microfarad-de/smart-pump/README.md

# Smart Water Pump

<p align="center">
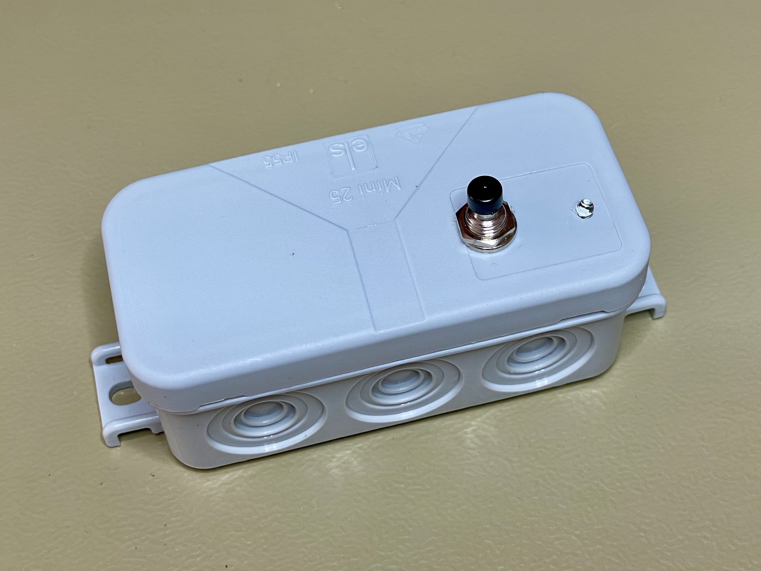
[picture p1: doc/enclosure-1.jpeg]
  
</p>

This repository contains the Arduino firmware for smart water pump controller.

The code has been implemented and tested on an Arduino Pro Mini clone board based on the ATmega328P microcontroller.

This project uses Git submodules. In order to get its full source code, please clone this Git repository to your local workspace, then execute the follwoing command from within the repository's root directory: `git submodule update --init`.

Unless stated otherwise within the source file headers, please feel free to use and distribute this code under the GNU General Public License v3.0.

## Prerequisites

* ATmega328P based Arduino Pro Mini, Arduino Nano or similar model
* Desolder the on board voltage regulator and power LED from the Arduino board
* Custom bootloader from: https://github.com/microfarad-de/bootloader

## Theory of Operation

The smart water pump controller is a convenience feature for caravaning applications.
The caravan's on board water tank is filled using a portable canister.
A 12 Volt water pump is often used to transfer the water from the canister into the on board tank.

The smart pump controller has the following features:
* Automatically deactivate the water pump if it runs dry
* Automatically deactivate the water pump if the caravan tank becomes full
* Top up the caravan tank when the caravan tank water level goes below the full threashold

The controller detects pump dry run condition by measuring its current draw.
The following table shows the approximate current draw of a "Comet Lux-Plus" water pump at 13.0 V:

| State | Current  |
|---|---|
| Pumping | 3.7 A |
| Output blocked | 2.4 A |
| Dry run | 0.6 A |

The controller sends AC voltage pulses across a pair of electrodes plunged into the caravan tank, and measures the resulting voltage drop in order to detect the full tank condition.

Pumping is started and stopped by pressing the push button. The pump will be automatically deactivated if the dry run condition has been detected.

If the full tank condition is detected, the controller will deactivate the pump and go into the standby mode. Whereas the controller will reactivate the water pump if
the water level inside the caravan tank goes below the preset full threshold.

A status LED indicates the operation status through different blinking patterns as shown in the table below:

| Blinking Pattern | Description |
|---|---|
| Always on | Pumping water |
| Always off | Power off state, press button to start pumping |
| Blink once every 2 s | Standby state, the pump will start periodically  |
| Inverse blink every 0.5 s | Error, calibration needed |
| Even blink with 1 s period | Pumping current calibration |
| Even blink with 0.5 s period  | Dry run current calibration |

## Calibration Procedure

Enter the calibration mode by long-pressing the button during 5 seconds. Make sure that the pump is immersed in water and the output hose is not obstructued. The pump will start and the LED will blink evenly with a 1 second period to indicate the pumping current calibration.

Long-press the button during 1 second to store the current value for the regular pumping operation. The LED blinking period will decrease to 0.5 seconds to indicate the dry run current calibration.

Raise the pump above water level to ensure it is running dry, then long-press the button during 1 second to store the current value. If the calibration procedure was successful, the LED will turn off and the controller will go to the power off state.

If the LED stays constantly lit and briefly turns off twice per second, then calibration procedure has been faulty and needs to be repeated.

## Circuit Diagram

The following picture shows the smart pump controller circuit diagram:

<p align="center">
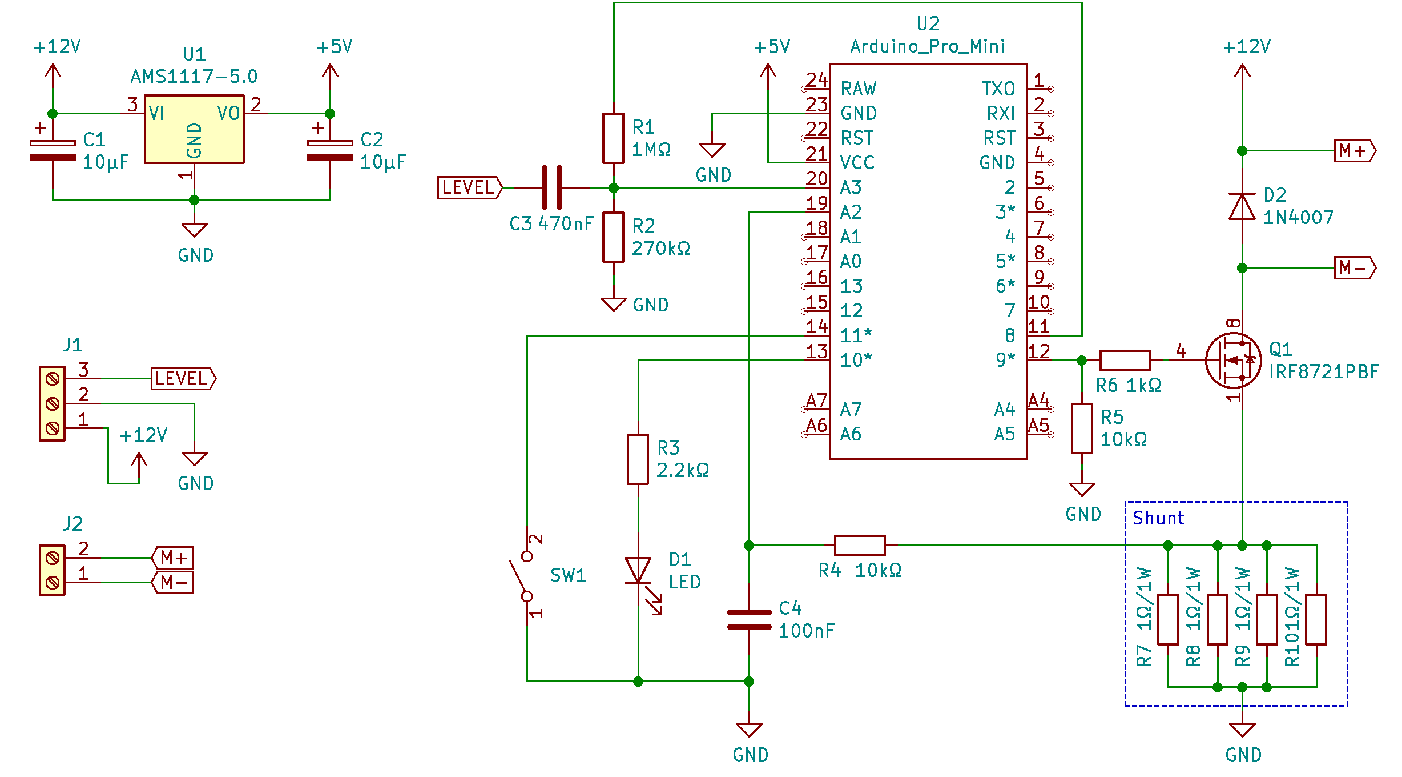
[picture p2: doc/schematic.png]
  
</p>

[schematic.pdf](doc/schematic.pdf)

## PCB Layout

The circuit is assembled on a prototyping stripboard PCB as shown in the follwoing pictures:

<p align="center">
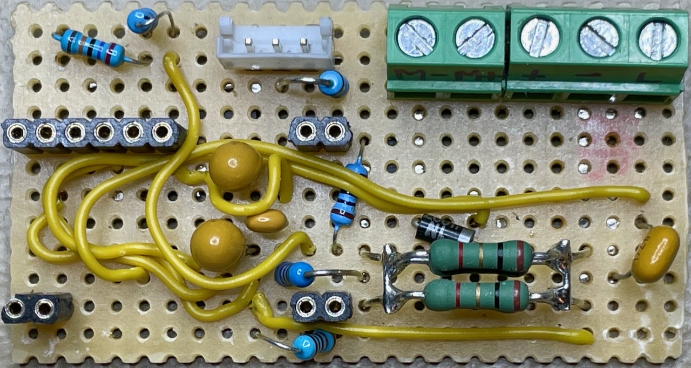
[picture p3: doc/pcb-top.jpeg]
  
</p>

<p align="center">
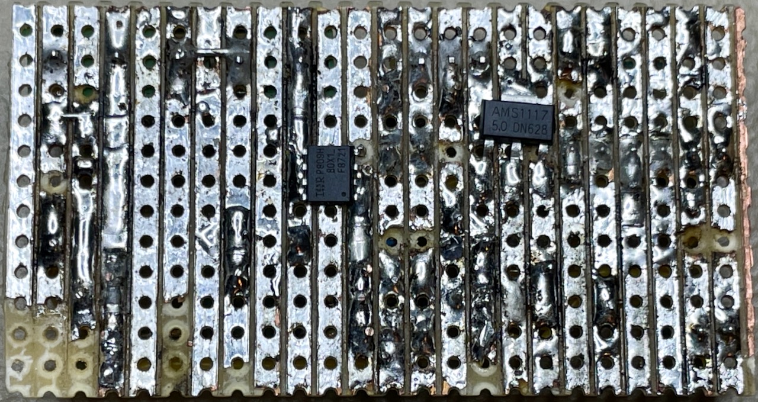
[picture p4: doc/pcb-bottom.jpeg]
  
</p>

## Gallery

Following are further pictures of the finished project:
<!--
<p align="center">
  <img src="doc/enclosure-2.jpeg" width="400"/>
</p>
-->
<p align="center">
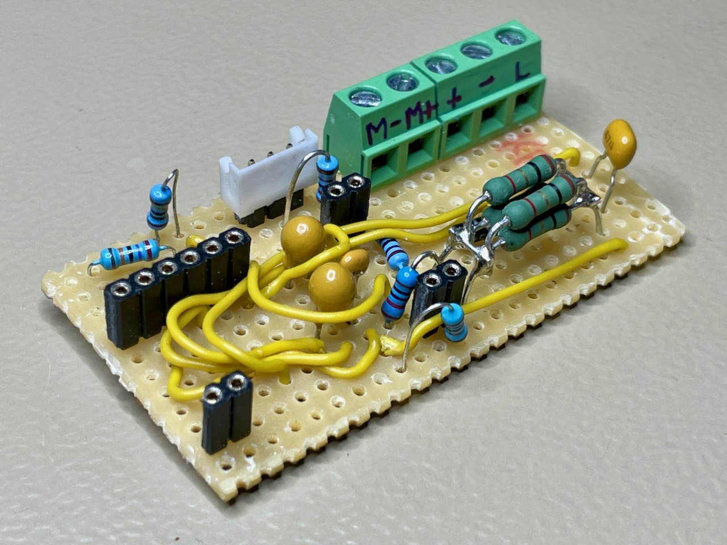
[picture p5: doc/perspective-1.jpeg]
  
</p>

<p align="center">
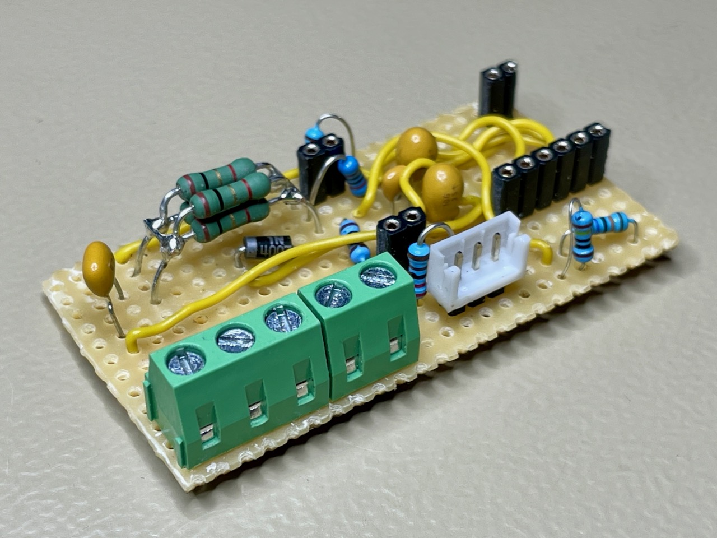
[picture p6: doc/perspective-2.jpeg]
  
</p>

<p align="center">
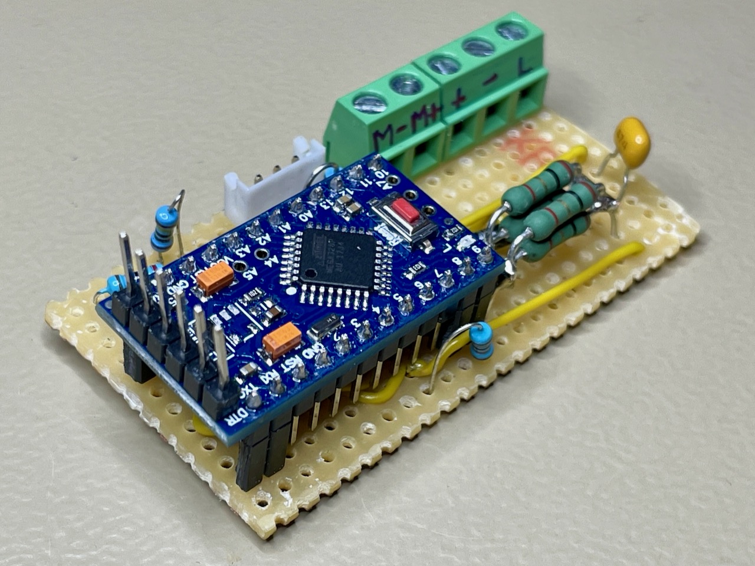
[picture p7: doc/perspective-3.jpeg]
  
</p>

<p align="center">
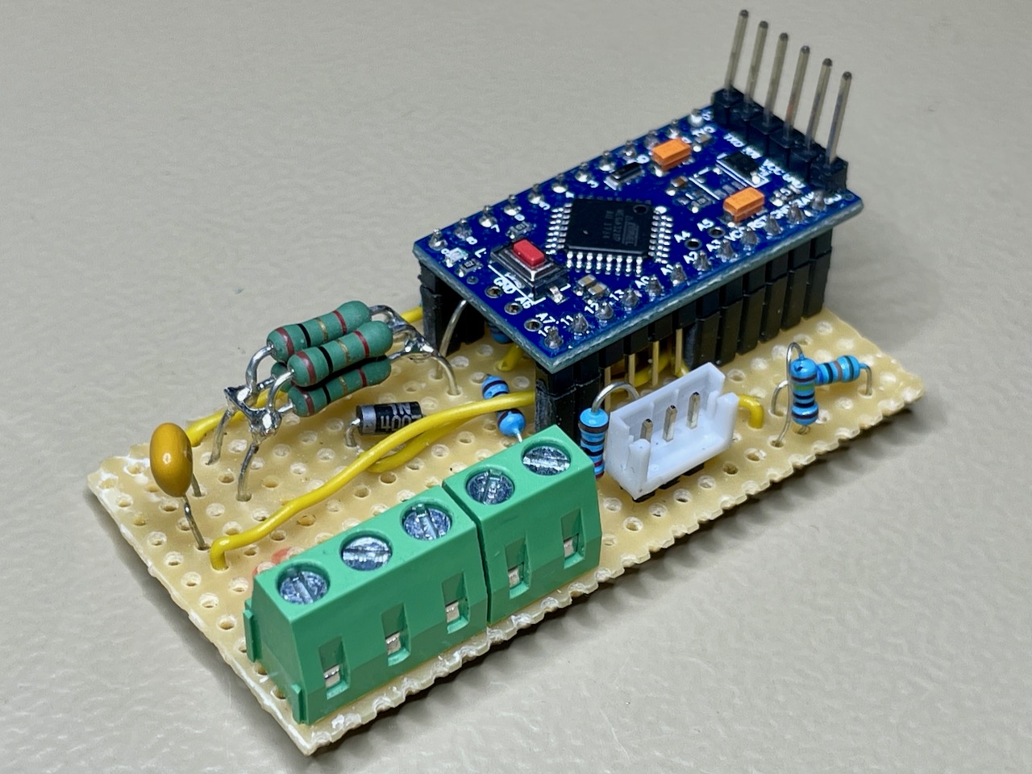
[picture p8: doc/perspective-4.jpeg]
  
</p>

<p align="center">
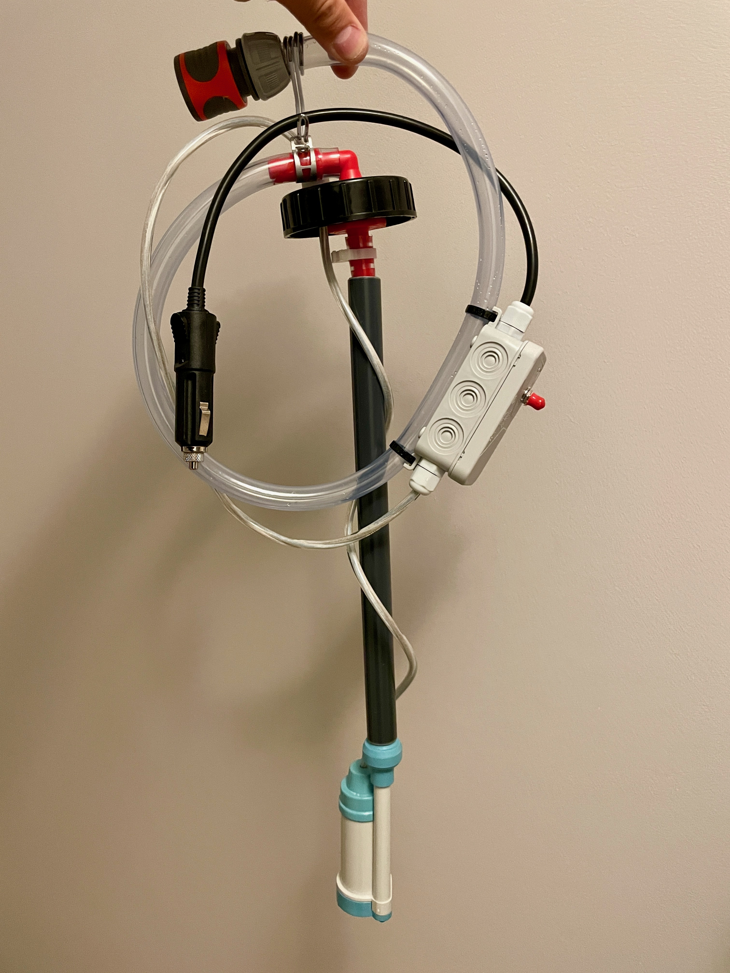
[picture p9: doc/final-1.jpeg]
  
</p>

<p align="center">
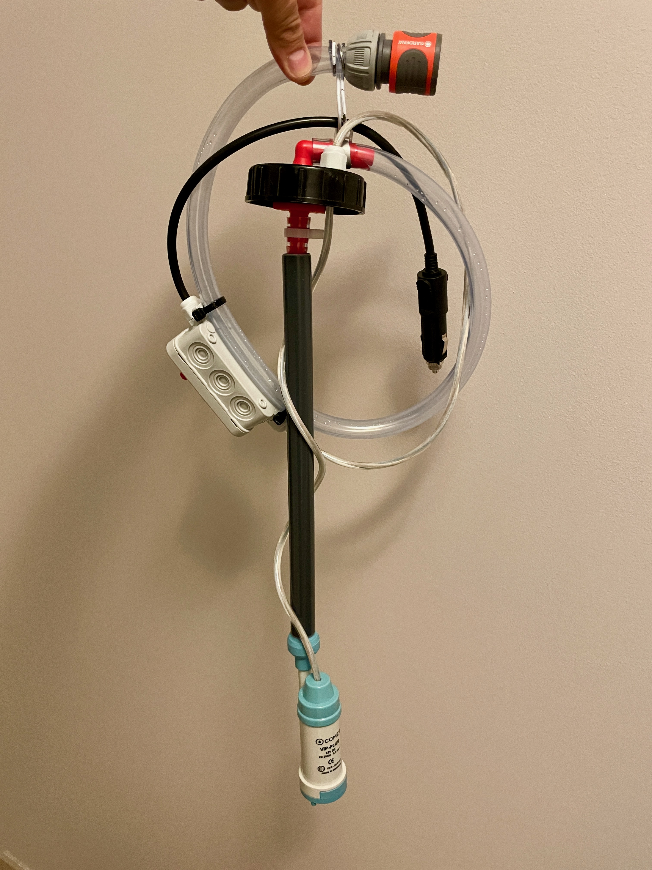
[picture p10: doc/final-2.jpeg]
  
</p>

<p align="center">
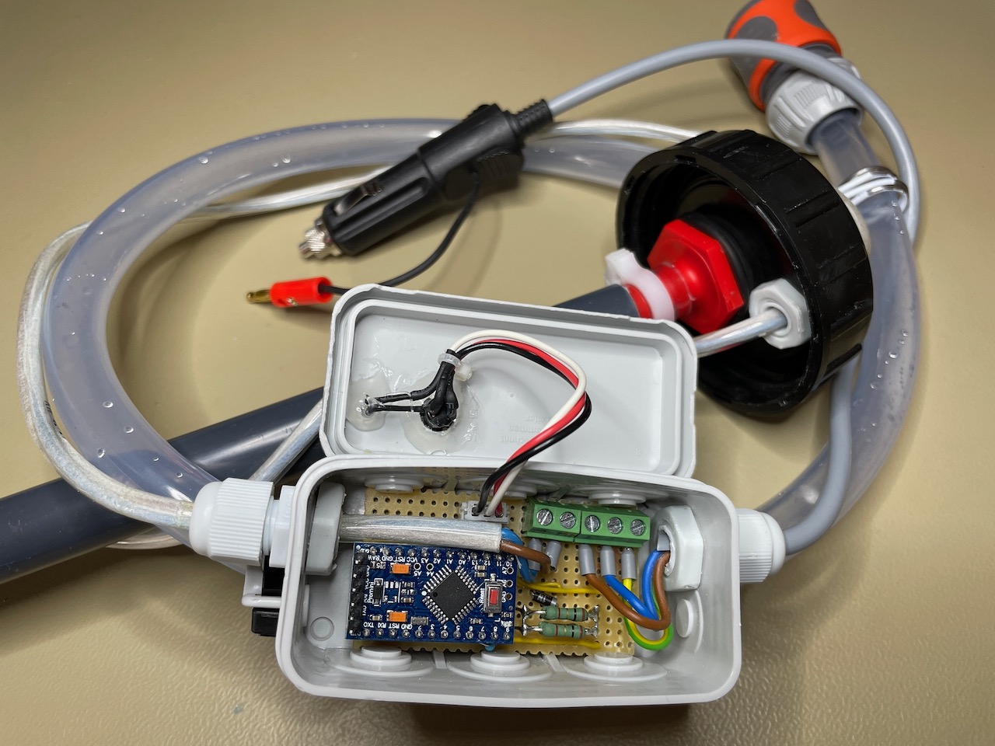
[picture p11: doc/final-3.jpeg]
  
</p>

<p align="center">
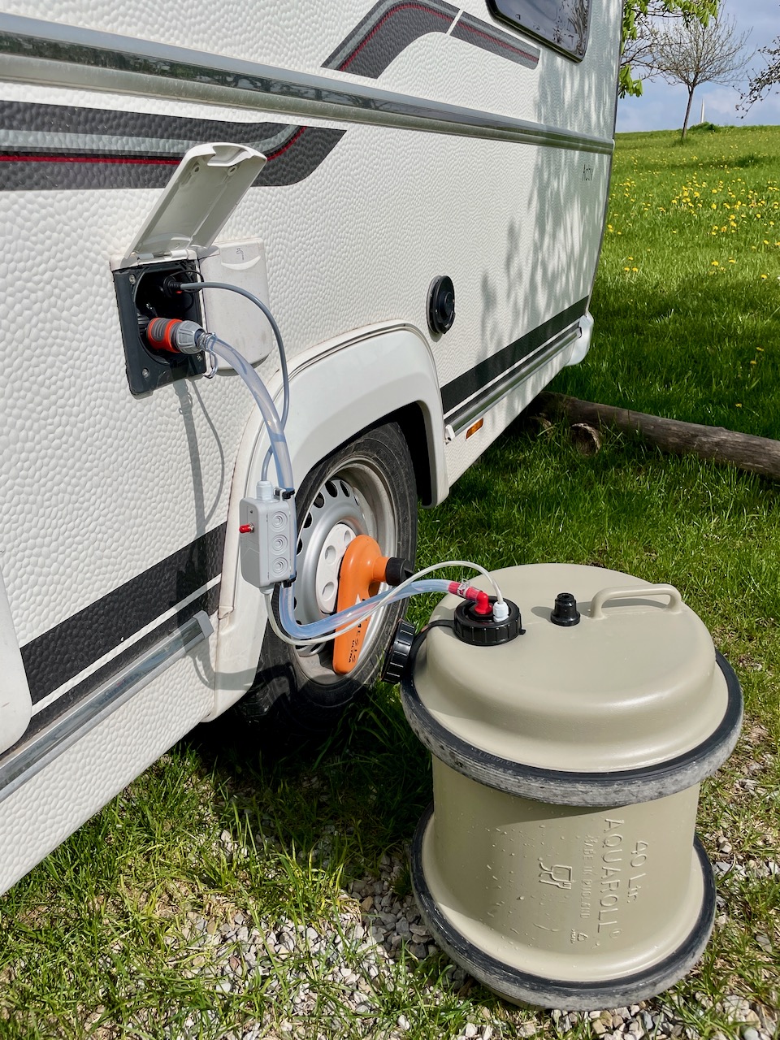
[picture p12: doc/final-4.jpeg]
  
</p>
