microfarad-de/smart-pump/doc/enclosure-2.jpeg

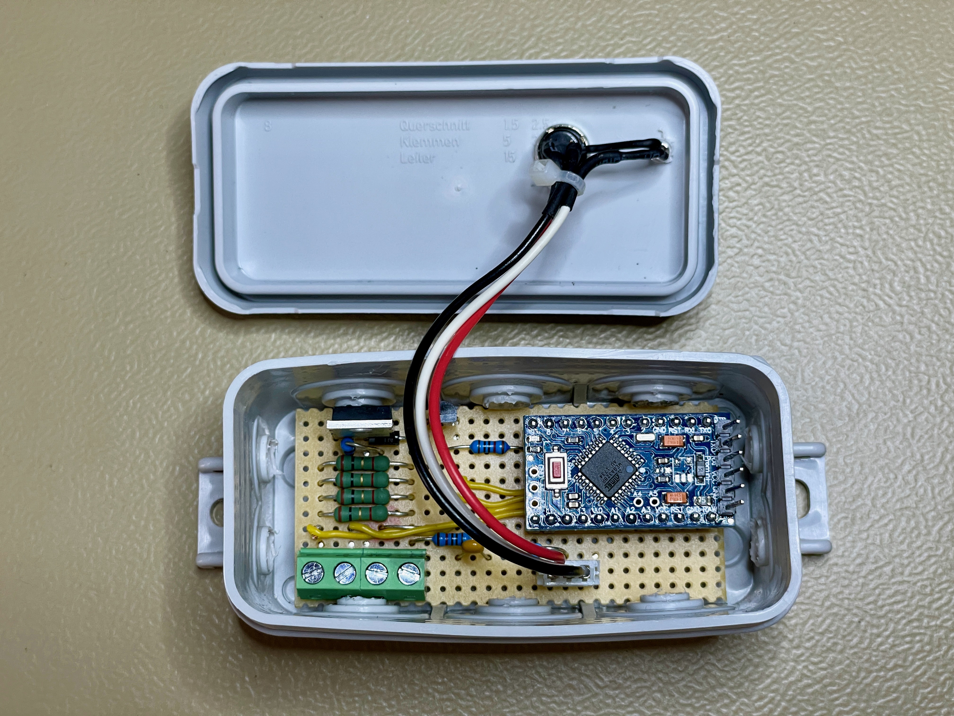
doc/enclosure-2.jpeg
