microfarad-de/smart-pump/doc/schematic.pdf

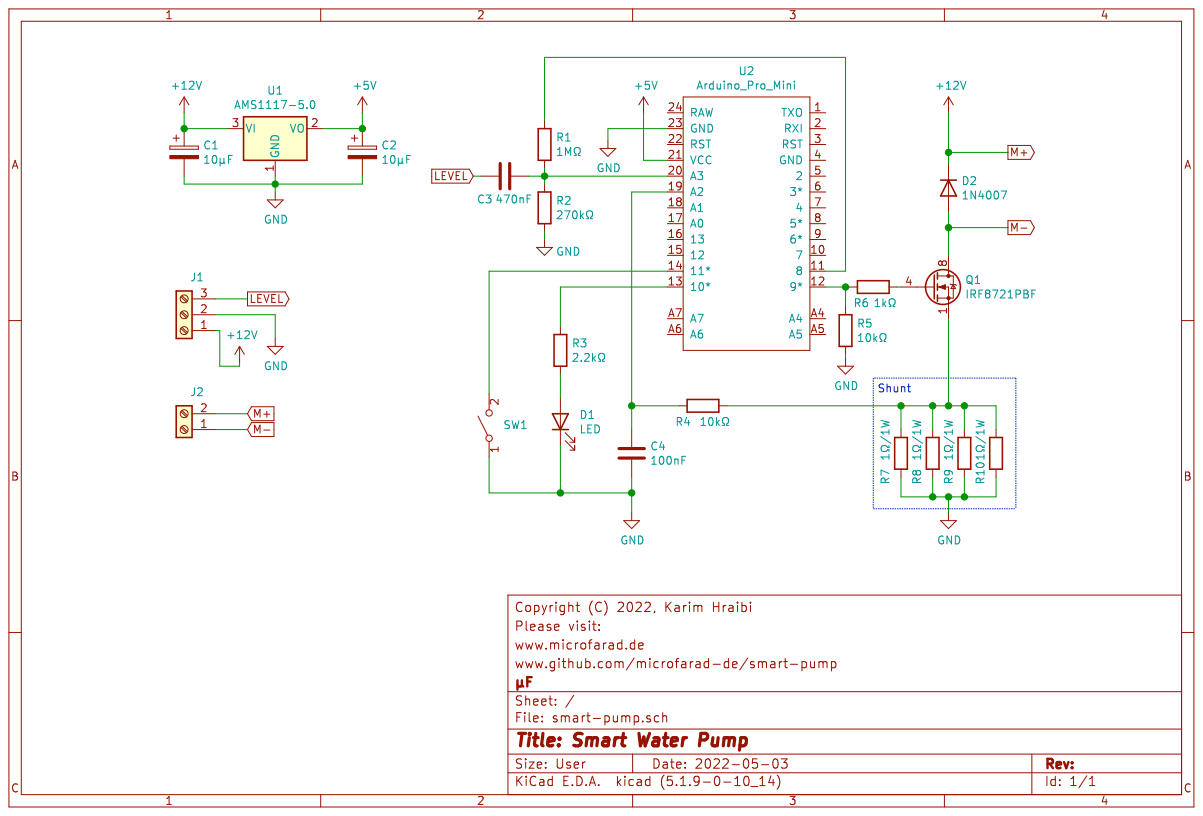
[picture p14: page 1]
