microfarad-de/smart-pump/smart-pump.ino

/*
 * Smart Water Pump
 *
 * Smart water pump controller.
 *
 * This sketch has been implemented and tested on an ATMega328P based Arduino Pro Mini
 * compatible board running on 3.3V/8MHz.
 *
 * It is recommended to activate the watchdog support on the Arduino bootloader
 * by defining the WATCHDOG_MODS macro. This will reduce the bootloader's power-up
 * delay, thus invalidating the need to hold the power button for around 2 seconds for
 * the system to turn on.
 *
 * This source file is part of the follwoing repository:
 * http://www.github.com/microfarad-de/smart-pump
 *
 * Please visit:
 *   http://www.microfarad.de
 *   http://www.github.com/microfarad-de
 *
 * Copyright (C) 2022 Karim Hraibi (khraibi@gmail.com)
 *
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
 * Version: 3.5.0
 * Date:    July 22, 2026
 */

#define VERSION_MAJOR 3  // Major version
#define VERSION_MINOR 5  // Minor version
#define VERSION_MAINT 0  // Maintenance version


#include <Arduino.h>
#include <avr/sleep.h>
#include <avr/wdt.h>
#include "src/Adc/Adc.h"
#include "src/Cli/Cli.h"
#include "src/Led/Led.h"
#include "src/Nvm/Nvm.h"
#include "src/Button/Button.h"



/*
 * Pin assignment
 */
#define NUM_APINS           2  // Number of analog pins in use
#define I_APIN       ADC_PIN2  // Analog pin for sensing the pump current draw
#define LEVEL_APIN   ADC_PIN3  // Analog pin connected to the onboard tank water level probe
#define MOSFET_PIN          9  // Digital output pin controlling the gate of the power MOSFET
#define LED_PIN            10  // Digital output pin controlling the status LED
#define BUTTON_PIN         11  // Digital input pin reading the push button
#define LEVEL_PULSE_PIN     8  // Digital output pin generating pulses for the level probe


/*
 * Configuration parameters
 */
//#define SIM                          // Simulator build
//#define SAVE_LAST_VALUES             // Save last read current and level values to EEPROM
#define SERIAL_BAUD            115200  // Serial communication baud rate
#define ADC_AVG_SAMPLES            16  // Number of ADC samples to be averaged
#define ADC_I_FROST_THR          1000  // ADC current reading threshold for triggering frost protection
#define ADC_LEVEL_HIGH_THR        700  // ADC reading threshold for detecting a full onboard tank (dry: 920)
#define ADC_LEVEL_LOW_THR         700  // ADC reading threshold for detecting a non-full onboard tank (dry: 860 plugged / 830 unplugged)
#define DEBOUNCE_SAMPLES           20  // Button debouncing level (ms until a button press is detected)
#define CAL_PRESS_DURATION       5000  // Long button press duration in ms to enter the calibration mode
#define APPLY_PRESS_DURATION     1000  // Long button press duration in ms to apply the calibration setting
#define MEAS_DURATION            1000  // Pump current measurement duration in ms
#define PUMP_TIMEOUT               10  // Maximum pump run duration in minutes
#define TOP_UP_DELAY                0  // Delay in seconds before restarting the pump after going into the standby state
#define STANDBY_DELAY               5  // Delay in seconds before going into the standby state
#define LEVEL_PULSE_PERIOD        100  // Period in ms of the level probe power pulse


/*
 * Global variables
 */
struct {
  enum {
    ERROR_E, ERROR,
    OFF_E, OFF,
    STANDBY_E, STANDBY,
    PUMP_E, PUMP,
    CAL_E, CAL_I_PUMP, CAL_I_DRY} state = OFF_E;  // Main state
  uint16_t iAdcVal;           // ADC pump current reading value
  uint16_t levelAdcValH = 0;  // ADC water level probe reading value at its high peak
  uint16_t levelAdcValL = 0;  // ADC water level probe reading value at its low peak
  uint16_t levelAdcVal;       // ADC water level probe reading peak to peak
  uint16_t mosfet;            // MOSFET switch state
  uint16_t iThrDry;           // Current threshold for dry run detection
} G;


/*
 * Parameters stored in EEPROM (non-volatile memory)
 */
struct {
  uint16_t iDry;       // ADC reading when the pump is running dry
  uint16_t iPump;      // ADC reading for regular pumping operation
                       // Note: iDry < iPump
  uint16_t iLast;      // Last registered current before switching to standy state
  uint16_t levelLast;  // Last registered onboard tank level value
} Nvm;


/*
 * Return value of levelPulse()
 */
typedef enum {
  LEVEL_NONE,
  LEVEL_HIGH,
  LEVEL_LOW
} Level_e;


/*
 * Objects
 */
ButtonClass Button;
LedClass    Led;


/*
 * Function declarations
 */
Level_e levelPulse  (void);
void    powerSave   (void);
void    saveLastVal (void);
void    nvmRead     (void);
void    nvmWrite    (void);
void    nvmValidate (void);
void    mosfetOff   (void);
void    mosfetOn    (void);
int     cmdShow     (int argc, char **argv);
int     cmdRom      (int argc, char **argv);
int     cmdSetNvm   (int argc, char **argv);
void    printVersion (uint8_t indent);



/*
 * Initialization routine
 */
void setup () {
  // Clear watchdog reset flag
  MCUSR &= ~(1 << WDRF);
  // Enable the watchdog timer
  wdt_enable (WDTO_8S);

  // Configure all unused pins as INPUT_PULLUP to avoid
  // excessive power draw due to toggling floating pins
  // except crystal pins.
  DDRB  = 0x00;
  DDRC  = 0x00;
  DDRD  = 0x00;
  PORTB = 0x3F;   // D8–D13 pull-ups enabled
  PORTC = 0x3F;   // A0–A5 pull-ups enabled
  PORTD = 0xFF;   // D0–D7 pull-ups enabled

  pinMode      (A2, INPUT);
  pinMode      (A3, INPUT);
  pinMode      (LED_BUILTIN, OUTPUT);
  digitalWrite (LED_BUILTIN, LOW);
  pinMode      (MOSFET_PIN, OUTPUT);
  digitalWrite (MOSFET_PIN, LOW);
  pinMode      (LEVEL_PULSE_PIN, OUTPUT);
  digitalWrite (LEVEL_PULSE_PIN, LOW);
  pinMode      (BUTTON_PIN, INPUT_PULLUP);

  Cli.init ( SERIAL_BAUD );
  Serial.println ("");
  Serial.println (F("+ + +  S M A R T  P U M P  + + +"));
  Serial.println ("");
  printVersion (0);
  Serial.println ("");
  Serial.println (F("'h' for help"));
  Cli.newCmd     ("s"   , "Show real time readings"                  , cmdShow);
  Cli.newCmd     ("."   , ""                                         , cmdShow);
  Cli.newCmd     ("r"   , "Show the calibration data"                , cmdRom);
  Cli.newCmd     ("n"   , "Set NVM value (arg: <idx> <value>)"       , cmdSetNvm);

  AdcPin_t adcPins[NUM_APINS] = {I_APIN, LEVEL_APIN};
  Adc.initialize (ADC_PRESCALER_128, ADC_INTERNAL, ADC_AVG_SAMPLES, NUM_APINS, adcPins);
  Button.initialize (BUTTON_PIN, LOW, DEBOUNCE_SAMPLES);
  Led.initialize (LED_PIN);

  nvmRead ();
}


/*
 * Main loop
 */
void loop () {
  static uint32_t dryMeasTs   = 0;
  static uint32_t levelMeasTs = 0;
  static uint32_t topUpTs     = 0;
  static uint32_t calTs       = 0;
  static uint32_t pumpTs      = 0;
  static uint32_t frostTs     = 0;
  static bool     standby     = false;
  Level_e         level;
  uint32_t ts = millis ();

  Cli.getCmd ();
  Button.read ();
  Button.rising ();
  Led.loopHandler ();

  if ( G.state < G.CAL_E) {
    if (Button.longPress (CAL_PRESS_DURATION)) {
      G.state = G.CAL_E;
    }
  }
  else {
    if (Button.falling ()) {
      G.state = G.OFF_E;
      nvmValidate ();
    }
    if (ts - calTs > PUMP_TIMEOUT * 60000) {
      G.state = G.OFF_E;
      nvmValidate ();
    }
  }

  if (Adc.readAll ()) {
    G.iAdcVal = Adc.result[I_APIN];
    level = levelPulse ();
    if (level == LEVEL_HIGH) {
      G.levelAdcValH = Adc.result[LEVEL_APIN];
      G.levelAdcVal = G.levelAdcValH - G.levelAdcValL;
    }
    else if (level == LEVEL_LOW) {
      G.levelAdcValL = Adc.result[LEVEL_APIN];
      #ifdef SIM
      if (G.levelAdcValL > 511) G.levelAdcValL = 1023 - G.levelAdcValL;
      #endif
      G.levelAdcVal = G.levelAdcValH - G.levelAdcValL;
    }
  }

  // If iAdcVal exceeds ADC_I_FROST_THR for MEAS_DURATION,
  // then turn off the pump.
  if (G.iAdcVal < ADC_I_FROST_THR) {
    frostTs = ts;
  }
  else if (ts - frostTs > MEAS_DURATION && G.state > G.OFF) {
    G.state = G.OFF_E;
  }

  switch (G.state) {

    // ERROR: Wrong calibration data, please calibrate
    case G.ERROR_E:
      mosfetOff ();
      Led.blink (-1, 500, 100);
      G.state = G.ERROR;
      [[fallthrough]]
    case G.ERROR:
      break;

    // OFF: No pumping until button is pressed
    case G.OFF_E:
      mosfetOff ();
      Led.turnOff ();
      Led.blink (1, 100, 0);
      standby = false;
      G.state = G.OFF;
      [[fallthrough]]
    case G.OFF:
      if (Button.falling()) {
        G.state = G.PUMP_E;
      }
      break;

    // STANDBY: Periodically activate pump to top-up the water tank
    case G.STANDBY_E:
      mosfetOff ();
      Led.blink (-1, 100, 1900);
      levelMeasTs = ts;
      topUpTs     = ts;
      standby     = true;
      G.state     = G.STANDBY;
      [[fallthrough]]
    case G.STANDBY:
      if (Button.falling()) {
        G.state = G.OFF_E;
      }

      // If levelAdcVal exceeds ADC_LEVEL_LOW_THR for more than MEAS duration,
      // then start pumping. levelAdcVal increases with decreasing water level.
      if (G.levelAdcVal < ADC_LEVEL_LOW_THR || ts - topUpTs < TOP_UP_DELAY * 1000) {
        levelMeasTs = ts;
      }
      else if (ts - levelMeasTs > MEAS_DURATION) {
        G.state = G.PUMP_E;
      }
      break;

    // PUMP: Pumping water
    case G.PUMP_E:
      mosfetOn ();
      Led.turnOn ();
      dryMeasTs   = ts;
      levelMeasTs = ts;
      pumpTs      = ts;
      G.state     = G.PUMP;
      [[fallthrough]]
    case G.PUMP:
      if (Button.falling ()) {
        saveLastVal ();
        G.state = G.OFF_E;
      }

      if (G.levelAdcVal > ADC_LEVEL_HIGH_THR) {
        levelMeasTs = ts;
      }
      else if (ts - levelMeasTs > (standby ? STANDBY_DELAY * 1000 : MEAS_DURATION)) {
        saveLastVal ();
        G.state = G.STANDBY_E;
      }

      if (G.iAdcVal > G.iThrDry) {
        dryMeasTs = ts;
      }
      else if (ts - dryMeasTs > MEAS_DURATION) {
        saveLastVal ();
        G.state = G.OFF_E;
      }

      if (ts - pumpTs > PUMP_TIMEOUT * 60000) {
        saveLastVal ();
        G.state = G.OFF_E;
      }
      break;

    // CAL: Calibration
    case G.CAL_E:
      mosfetOn ();
      Led.blink (-1, 500, 500);
      calTs = ts;
      G.state = G.CAL_I_PUMP;
      [[fallthrough]]

    // Calibrate pumping current
    case G.CAL_I_PUMP:
      if (Button.longPress (APPLY_PRESS_DURATION)) {
        Nvm.iPump = G.iAdcVal;
        Led.blink (-1, 250, 250);
        calTs = ts;
        nvmWrite ();
        G.state = G.CAL_I_DRY;
      }
      break;

    // Calibrate dry run current
    case G.CAL_I_DRY:
      if (Button.longPress (APPLY_PRESS_DURATION)) {
        Nvm.iDry = G.iAdcVal;
        G.state = G.OFF_E;
        nvmWrite ();
      }
      break;

    default:
      mosfetOff ();
      Led.turnOff ();
      G.state = G.OFF_E;
      break;

  }

  wdt_reset();
  powerSave();
}


/*
 * Toggle the digital output pin for powering the water level probe
 */
Level_e levelPulse (void) {
  static uint32_t pulseTs = 0;
  static uint8_t  state   = LOW;
  uint32_t ts = millis ();

  if (state == LOW) {
    if (ts - pulseTs > (LEVEL_PULSE_PERIOD / 2)) {
      state   = HIGH;
      digitalWrite (LEVEL_PULSE_PIN, state);
      return LEVEL_LOW;
    }
  }
  else {
    if (ts - pulseTs > LEVEL_PULSE_PERIOD) {
      pulseTs = ts;
      state   = LOW;
      digitalWrite (LEVEL_PULSE_PIN, state);
      return LEVEL_HIGH;
    }
  }

  return LEVEL_NONE;
}


/*
 * Power saving routine
 * Enables CPU sleep mode
 */
void powerSave (void) {
  set_sleep_mode (SLEEP_MODE_IDLE);
  cli ();
  sleep_enable ();  // Enter sleep, wakeup will be triggered by the next Timer 0 interrupt
  sei ();
  sleep_cpu ();
  sleep_disable ();
}


/*
 * Save last I ADC value
 */
void saveLastVal (void) {
#ifdef SAVE_LAST_VALUES
  Nvm.iLast     = G.iAdcVal;
  Nvm.levelLast = G.levelAdcVal;
  nvmWrite ();
#endif
}


/*
 * Read EEPROM data
 */
void nvmRead (void) {
  eepromRead (0x0, (uint8_t*)&Nvm, sizeof (Nvm));
  nvmValidate ();
}


/*
 * Write EEPROM data
 */
void nvmWrite (void) {
  eepromWrite (0x0, (uint8_t*)&Nvm, sizeof (Nvm));
  nvmValidate ();
}


/*
 * Validate EEPROM data
 */
void nvmValidate (void) {
  if (Nvm.iDry >= Nvm.iPump - 100) G.state = G.ERROR_E;
  G.iThrDry  = (Nvm.iDry + Nvm.iPump) / 2;
}


/*
 * Turn off pump MOSFET
 */
void mosfetOff (void) {
  G.mosfet = LOW;
  digitalWrite (MOSFET_PIN, G.mosfet);
}


/*
 * Turn on pump MOSFET
 */
void mosfetOn (void) {
  G.mosfet = HIGH;
  digitalWrite (MOSFET_PIN, G.mosfet);
}


/*
 * CLI command for displaying the ADC reading
 */
int cmdShow (int argc, char **argv) {
  Cli.xprintf ("Realtime data:\r\n");
  Cli.xprintf ("  State   = %u\r\n", G.state);
  Cli.xprintf ("  MOSFET  = %u\r\n", G.mosfet);
  Cli.xprintf ("  I_adc   = %u\r\n", G.iAdcVal);
  Cli.xprintf ("  L_adc_h = %u\r\n", G.levelAdcValH);
  Cli.xprintf ("  L_adc_l = %u\r\n", G.levelAdcValL);
  Cli.xprintf ("  L_adc   = %u\r\n", G.levelAdcVal);
  Serial.println ("");
  return 0;
}


/*
 * CLI command for displaying the calibration data
 */
int cmdRom (int argc, char **argv) {
  Cli.xprintf ("Calibration data:\r\n");
  Cli.xprintf ("  I_dry     = %u\r\n", Nvm.iDry);
  Cli.xprintf ("  I_pump    = %u\r\n", Nvm.iPump);
  Cli.xprintf ("  I_thr_dry = %u\r\n", G.iThrDry);
#ifdef SAVE_LAST_VALUES
  Cli.xprintf ("  I_last    = %u\r\n", Nvm.iLast);
  Cli.xprintf ("  L_last    = %u\r\n", Nvm.levelLast);
#endif
  printVersion (2);
  Serial.println ("");
  return 0;
}


/*
 * Set an NVM value
 */
int cmdSetNvm (int argc, char **argv) {
  uint16_t idx;
  uint16_t val;
  uint16_t *ptr = (uint16_t *)&Nvm;
  if (argc == 3) {
    idx = atoi(argv[1]);
    val = atoi(argv[2]);
  }
  else {
    return 1;
  }
  ptr[idx] = val;
  Cli.xprintf ("Nvm[%u] = %u\r\n", idx, ptr[idx]);
  Serial.println ("");
  nvmWrite ();
  return 0;
}


/*
 * Print version info
 */
#define STRINGIFY(x) #x
#define QUOTE(x) STRINGIFY(x)
void printVersion (uint8_t indent)
{
  for (uint8_t i = 0; i < indent; i++) {
    Serial.print(" ");
  }
  Serial.println(F("V " QUOTE(VERSION_MAJOR) "." QUOTE(VERSION_MINOR) "." QUOTE(VERSION_MAINT)));
}
