microfarad-de/smart-pump/(commit log)

2022-04-02 Save WIP: verified basic Button and LED functionality
2022-04-02 Verified with a DC motor
2022-04-03 Added schematic and pictures
2022-04-03 Updated schematic
2022-04-05 Tweak LED blinking
2022-04-11 Implemented power supply measurement on ADC_PIN3
2022-04-12 Updated schematic and pictures
2022-04-17 Increase ADC averaging samples Move version number definitions into .ino file
2022-04-19 New features: - Voltage correction factor - Frost protection - Advanced debug capabilities
    [smart-pump.ino]
2022-04-21 Fixed ADC_AVG_SAMPLES overflow bug Added CLI command for setting arbitrary NVM values
    [smart-pump.ino]
2022-04-22 Set maximum pumping duration Reduced ADC averaging Improved save last values
2022-04-23 Reworked implementation for using a water level sensor electrode within the caravan tank
    [smart-pump.ino]
2022-04-23 Updated README.md and schematic
2022-04-25 Bugfix in Led submodule
2022-04-30 Updated schematic Disabled debug output
2022-05-02 Fine tune level calibration
2022-05-02 Fine tune level calibration Enable debug
2022-05-02 Updated schematic Recalibrated levels
2022-05-03 Calibrated level thresholds Updated schematic (10K protection resistor)
2022-05-03 Measure water resistance using AC current. Updated schematic and pictures.
2026-07-21 Added SIM switch for simulator builds Bugfix: frost detection repeatedly enter OFF_E state
    [smart-pump.ino]
2026-07-21 SLEEP_MODE_IDLE and watchdog timer
2026-07-22 Improved prints
